KrHaaland/5-Volt-Buck-with-UVLO/case/case-closed.png

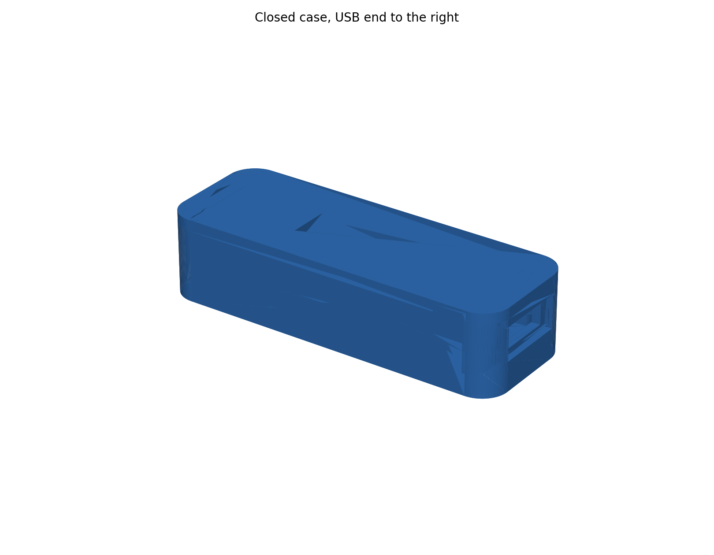
case/case-closed.png
