KrHaaland/5-Volt-Buck-with-UVLO/production/bom.csv

Designator | Footprint | Quantity | Value | LCSC Part #
_3, _2, |  | 3
C1, C10, C11, C2, C6, C7, C9 | 1206 | 7 | 10uF
C3, C5, C8 | 0805 | 3 | 100nF
C4 | 0805 | 1 | 33nF
J1 | Wago 2060-452 | 1 | Wago 2060-452 | C2765055
J2 | 292303-1 | 1 | 292303-1
L1 | 744393465068 | 1 | 7070_74439387068
R1 | 0805 | 1 | 511K
R2 | 0805 | 1 | 88.7K
R3, R4 | 0805 | 2 | 0 ohm
R6 | 0805 | 1 | 53.6k
R7 | 0805 | 1 | 10.2k
U1 | TPS62933 | 1 | TPS62933DRLR
