KrHaaland/5-Volt-Buck-with-UVLO/case/usb-adapter-case-assembled.step

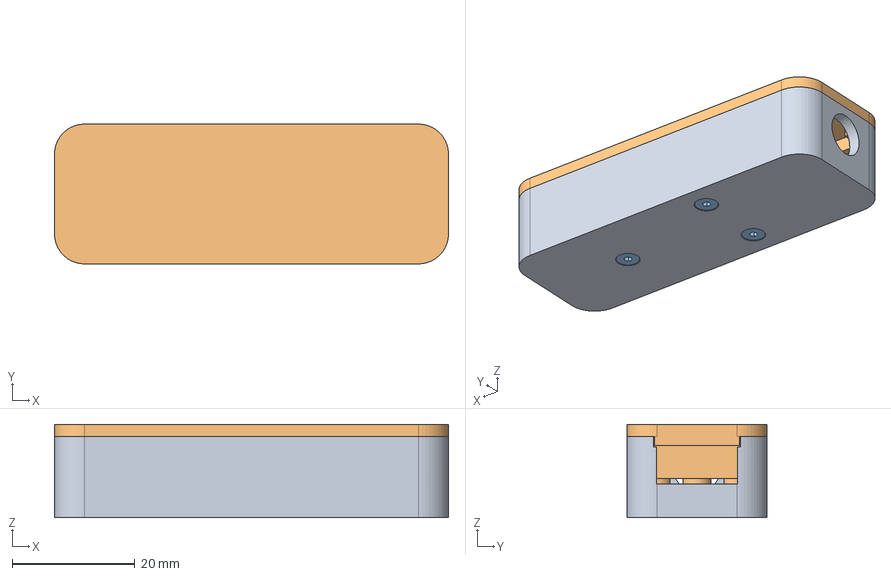
[picture p7: CAD file, 2026-11-08]
case/usb-adapter-case-assembled.step
64.2 x 22.8 x 15.2 mm
Case_Base
Case_Lid
Screw_M2x6_1
Screw_M2x6_2
Screw_M2x6_3
