KrHaaland/5-Volt-Buck-with-UVLO/case/usb-adapter-assembly.step

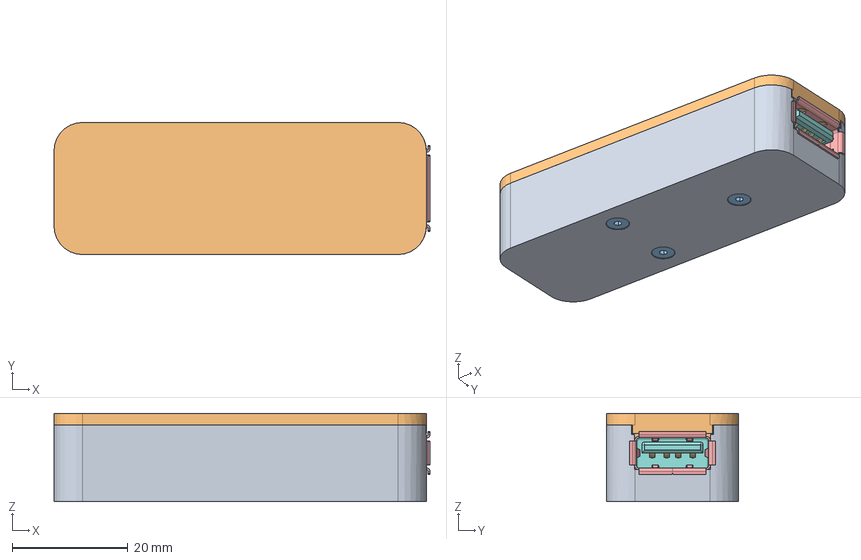
[picture p8: CAD file, 2026-11-08]
case/usb-adapter-assembly.step
64.9 x 22.8 x 15.2 mm
Base
Lid
Screw 1 M2x6 hex socket pan head
Screw 2 M2x6 hex socket pan head
Screw 3 M2x6 hex socket pan head
J1 Wago 2060-452
C6 C_1206_3216Metric
C8 C_0805_2012Metric
L1 L_Wurth_WE-XHMI-6060 (fitted part is a 7070)
C1 C_1206_3216Metric
U1 TPS62933
C9 C_1206_3216Metric
C11 C_1206_3216Metric
R4 R_0805_2012Metric
C3 C_0805_2012Metric
C7 C_1206_3216Metric
R6 R_0805_2012Metric
R1 R_0805_2012Metric
C2 C_1206_3216Metric
R7 R_0805_2012Metric
J2 292303-012
C5 C_0805_2012Metric
C4 C_0805_2012Metric
R2 R_0805_2012Metric
C10 C_1206_3216Metric
Board 40x18x1.6
