KrHaaland/5-Volt-Buck-with-UVLO/USB-Adapter.step

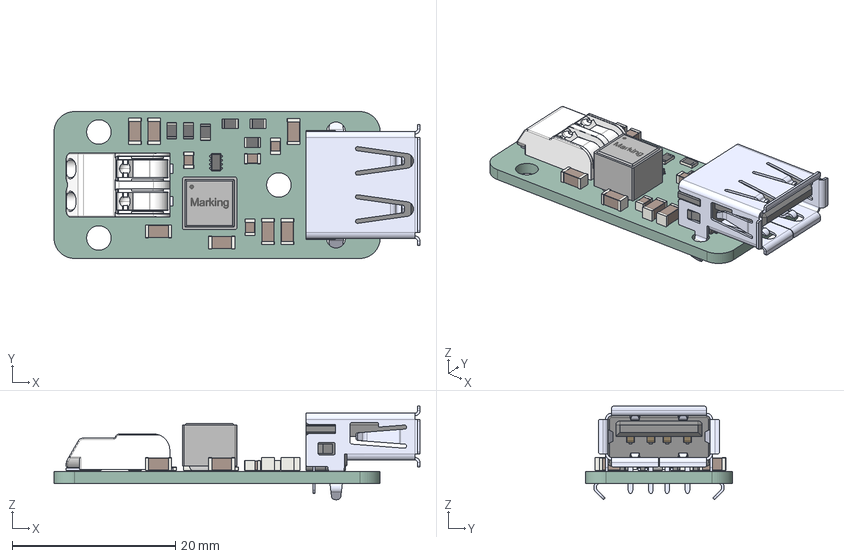
[picture p9: CAD file, 2026-11-01]
USB-Adapter.step
44.9 x 18.0 x 11.5 mm
C_1206_3216Metric x 7
C_0805_2012Metric x 4
L_Wurth_WE-XHMI_6060
BODY-SOT
R_0805_2012Metric x 6
USB-Adapter-unsaved-export-dCwAko_PCB
