KrHaaland/5-Volt-Buck-with-UVLO/case/usb-adapter-case-lid.step

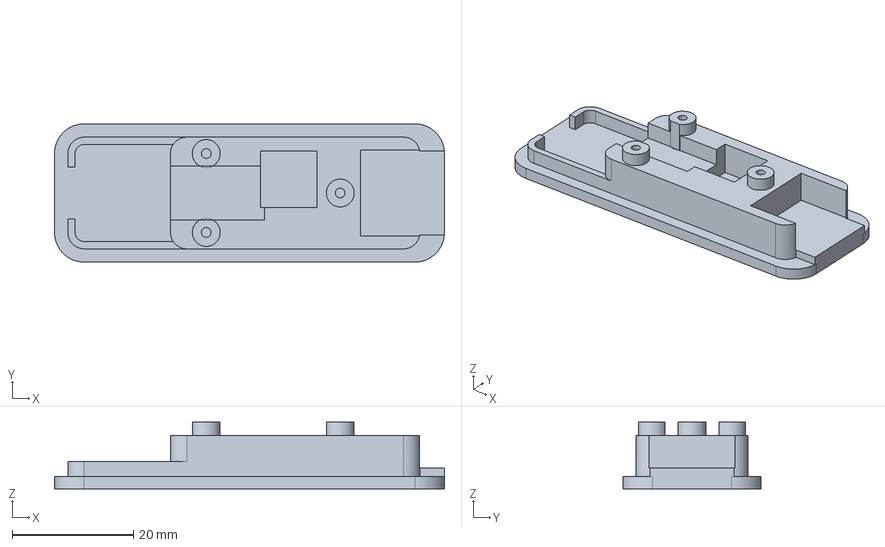
[picture p10: CAD file, 2026-11-08]
case/usb-adapter-case-lid.step
64.2 x 22.8 x 11.0 mm
