KrHaaland/5-Volt-Buck-with-UVLO/case/usb-adapter-case-base.step

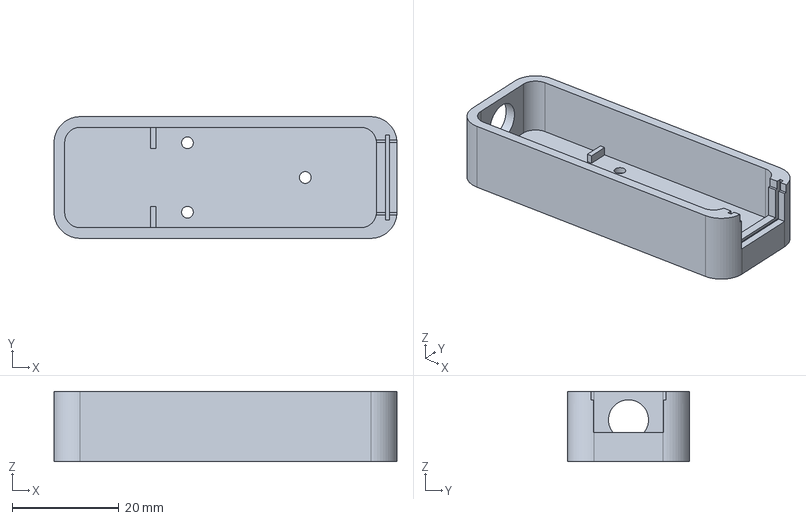
[picture p11: CAD file, 2026-11-08]
case/usb-adapter-case-base.step
64.2 x 22.8 x 13.2 mm
