KrHaaland/5-Volt-Buck-with-UVLO/case/usb-adapter-case.step

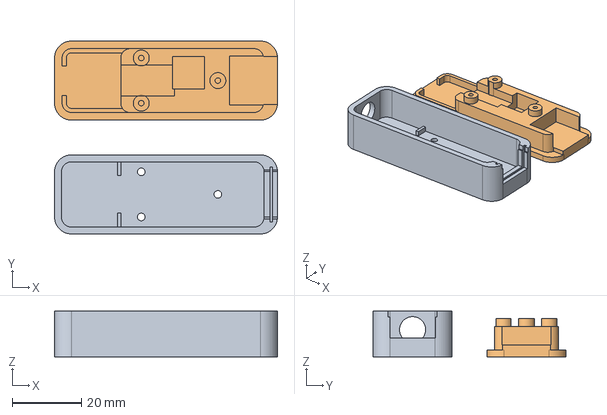
[picture p12: CAD file, 2026-11-08]
case/usb-adapter-case.step
64.2 x 55.6 x 13.2 mm
Base_print
Lid_print
