KrHaaland/5-Volt-Buck-with-UVLO/(list of files, cad)

Other CAD files:
case/usb-adapter-case-base.stl
case/usb-adapter-case-lid.stl
