KrHaaland/5-Volt-Buck-with-UVLO/schematic.pdf

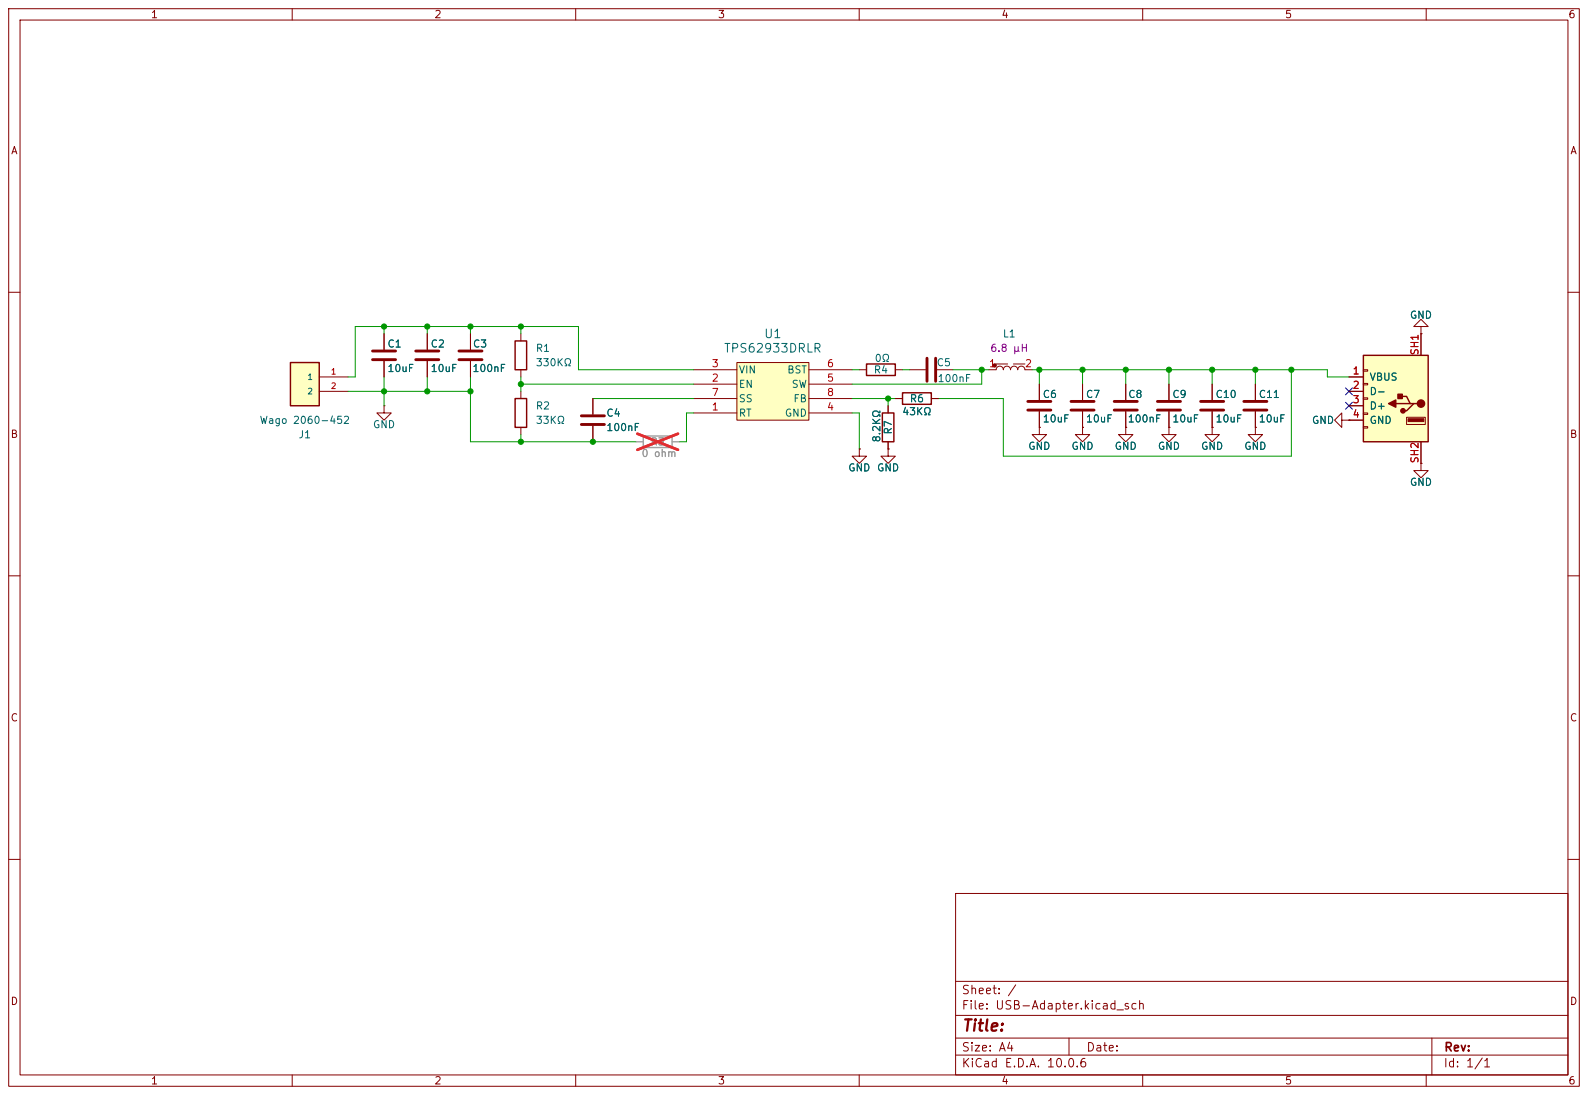
[picture p13: page 1]

Size: A4 | Rev:
KiCad E.D.A. 10.0.6 | Id: 1/1
