KrHaaland/5-Volt-Buck-with-UVLO/USB-Adapter.kicad_pcb

## KiCad design USB-Adapter.kicad_pcb (2026-10-31)

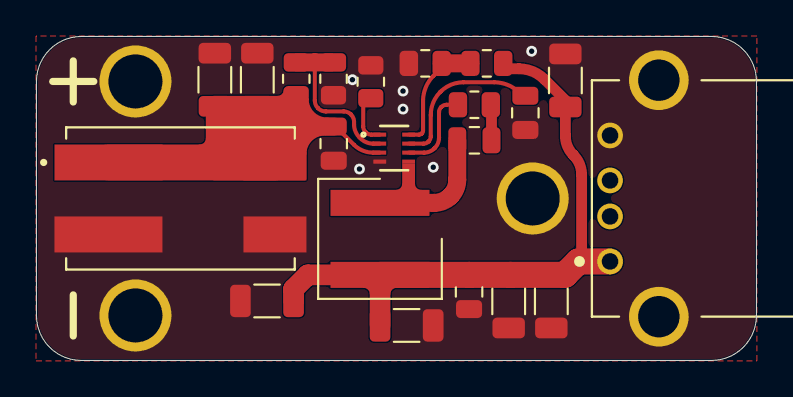
[picture p14: board USB-Adapter.kicad_pcb from above]

Board: 2 copper layers, 40.0 x 18.0 mm, 21 parts (0 on the bottom side), 10 nets.

Parts:
C1, C2, C6, C7, C9, C10, C11: 10uF; C_1206_3216Metric
C3, C5, C8: 100nF; C_0805_2012Metric
C4: 33nF; C_0805_2012Metric
J1: Wago 2060-452
J2: 292303-1
L1: 7070_74439387068; 744393465068
R1: 511K; R_0805_2012Metric
R2: 88.7K; R_0805_2012Metric
R3, R4: 0 ohm; R_0805_2012Metric
R6: 53.6k; R_0805_2012Metric
R7: 10.2k; R_0805_2012Metric
U1: TPS62933DRLR; TPS62933

Connections:
GND: C1.2, C2.2, C3.1, C4.2, C6.2, C7.2, C8.1, C9.2, C10.2, C11.2, J1.2, J2.4 (GND), J2.SH1, J2.SH2, R2.2, R3.2, R7.1, U1.4 (GND)
unnamed: C5.1, R4.2
unnamed: C6.1, C7.1, C8.2, C9.1, C10.1, C11.1, J2.1 (VBUS), L1.2, R6.2
unnamed: R4.1, U1.6 (BST)
unnamed: R1.2, R2.1, U1.2 (EN)
unnamed: R6.1, R7.2, U1.8 (FB)
unnamed: R3.1, U1.1 (RT)
unnamed: C4.1, U1.7 (SS)
unnamed: C5.2, L1.1, U1.5 (SW)
unnamed: C1.1, C2.1, C3.2, J1.1, R1.1, U1.3 (VIN)
