KrHaaland/5-Volt-Buck-with-UVLO/(commit log)

2026-10-31 Initial commit: 5 Volt Buck with UVLO KiCad project
    USB-Adapter schematic, PCB and production outputs (BOM, positions, netlist).
    [USB-Adapter.kicad_pcb, USB-Adapter.kicad_sch, bom.csv, designators.csv, positions.csv]
2026-10-31 Add README with as-built resistor values and tuning log
2026-10-31 Add schematic PDF and note on disabling UVLO
2026-10-31 Add 3D render of the board to README
2026-10-31 Add photo of the assembled board
2026-11-01 Add 3D-printable case (STEP/STL) generated from the PCB geometry
    Claude-Session: https://claude.ai/code/session_01GDeBLW4npXiq4WbrnEu7Dp
    [usb-adapter-case-assembled.step, usb-adapter-case-base.stl, usb-adapter-case-lid.stl, usb-adapter-case.step]
2026-11-01 Case: 1 mm standoff (pins trimmed flush), 10 mm wire-end extension with zip-tie anchor
    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
    [usb-adapter-case-assembled.step, usb-adapter-case-base.stl, usb-adapter-case-lid.stl, usb-adapter-case.step]
2026-11-01 Case: drop zip-tie floor slots, extension is plain space for a tie as pull stop
    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
    [usb-adapter-case-assembled.step, usb-adapter-case-base.stl, usb-adapter-case.step]
2026-11-01 Case: model the three M2.5 screws in the assembled STEP, add section view
    - Screws (pan head 5.0 x 2.0 mm, shank 2.5 x 10 mm) as separate solids in
    usb-adapter-case-assembled.step; check confirms they clear base and board
    and engage 6.9 mm in the lid bosses
    - Floor counterbore 1.8 -> 2.1 mm so a pan head sits below the bottom face;
    lid pilot hole 7.0 -> 7.5 mm deep for tip clearance
    - case-section.png half section through the screw stack; README fastening
    text expanded
    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
    [usb-adapter-case-assembled.step, usb-adapter-case-base.stl, usb-adapter-case-lid.stl, usb-adapter-case.step]
2026-11-01 Case: build the check and assembled model from the KiCad STEP export of the board
    - Add USB-Adapter.step (populated board exported from KiCad) and the project
    setting that records the export path
    - make_case.py reads that file, shifts it into the board frame and removes
    everything below the board bottom (pins are cut flush), then checks every
    component against base and lid for overlap and clearance; the old
    per-connector model loading via KICAD_3D_MODELS is gone
    - The two lid bosses beside the Wago were 0.25 mm from the connector body:
    flatten them on that side up to the connector height, now 0.45 mm
    - Assembled STEP and previews now contain the real populated board; the
    7070 ind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
    [USB-Adapter.step, usb-adapter-case-assembled.step, usb-adapter-case-lid.stl, usb-adapter-case.step]
2026-11-01 Case: add usb-adapter-assembly.step, a full STEP assembly of case and populated board
    - New two-level STEP assembly: Case (base, lid, three screws) and PCB (board
    plus every component), parts named by reference designator taken from the
    .kicad_pcb footprints; R3 is skipped because it is not populated
    - usb-adapter-case-assembled.step is now the enclosure only (base, lid, screws)
    - README file list updated
    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
    [usb-adapter-assembly.step, usb-adapter-case-assembled.step, usb-adapter-case.step]
2026-11-01 Case: add a lid-hidden view of the assembly to the README
    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
2026-11-01 Case: end wall reaches the USB flange, latch-tab groove, no vents
    - USB end wall now ends 0.3 mm short of the connector's front flange
    (measured at X 44.55 in the board frame), so only the flange shows
    outside; wall is 3.85 mm thick there, case 56.6 mm long
    - Groove inside that wall for the shell's side latch tabs
    - All vent slots removed (lid, floor, side walls): no heat to vent
    - README table and previews updated
    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
    [usb-adapter-assembly.step, usb-adapter-case-assembled.step, usb-adapter-case-base.stl, usb-adapter-case-lid.stl, usb-adapter-case.step]
2026-11-01 Case: 15 mm between board edge and wire-end wall, 7.5 mm cable hole
    - Wire-end extension measured from the board edge to the inside of the
    wall is now exactly 15 mm (was 10.4); case length 61.2 mm
    - Cable entry 7.5 mm with a 9.5 mm outside countersink
    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
    [usb-adapter-assembly.step, usb-adapter-case-assembled.step, usb-adapter-case-base.stl, usb-adapter-case-lid.stl, usb-adapter-case.step]
2026-11-01 Case: plain cable hole (no countersink) and a lid without openings
    - Cable entry is a straight 7.5 mm hole through the end wall
    - Wago push-button access slots removed from the lid
    - README and previews updated
    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
    [usb-adapter-assembly.step, usb-adapter-case-assembled.step, usb-adapter-case-base.stl, usb-adapter-case-lid.stl, usb-adapter-case.step]
2026-11-01 Case: 18 mm between board edge and wire-end wall
    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
    [usb-adapter-assembly.step, usb-adapter-case-assembled.step, usb-adapter-case-base.stl, usb-adapter-case-lid.stl, usb-adapter-case.step]
2026-11-01 Case: separate STEP files for base and lid
    - usb-adapter-case-base.step and usb-adapter-case-lid.step, each one
    solid in print orientation with the same XY footprint
    - Print-orientation moves are baked into the shapes with transformShape:
    translate() only sets a Placement, which a single-object STEP export
    drops (verified), and transformGeometry would turn the surfaces into
    B-splines
    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
    [usb-adapter-assembly.step, usb-adapter-case-assembled.step, usb-adapter-case-base.step, usb-adapter-case-base.stl, usb-adapter-case-lid.step, usb-adapter-case-lid.stl, usb-adapter-case.step]
2026-11-01 Case: lift cable hole 1.5 mm above the floor
    The hole bottom used to sit 0.35 mm above the floor. CABLE_LIFT now sets
    the gap from the floor top to the bottom of the hole; the centre height is
    derived from it (2.65 mm above the board top). All STEP/STL files and the
    previews are regenerated; clearance check unchanged (closest 0.31 mm at
    the USB flange, by design).
    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
    [usb-adapter-assembly.step, usb-adapter-case-assembled.step, usb-adapter-case-base.step, usb-adapter-case-base.stl, usb-adapter-case-lid.step, usb-adapter-case.step]
2026-11-01 Case: M2 x 6 screws, board moved 0.5 mm towards the cable end
    Screws are now M2 x 6 pan head (2.3 mm clearance holes, 1.6 mm pilots in
    the lid bosses, 4.6 x 2.1 mm counterbores); a 6 mm screw gives 2.9 mm of
    thread in the boss, a 5 mm one only 1.9 mm.
    After the first fit check the USB flange sat 0.5 mm further from the end
    wall than modelled. BOARD_DX moves the three screw positions, the board
    stops and the board model 0.5 mm towards the cable end relative to the
    box, closing that gap; USB_DX keeps the J2 model where the flange really
    is so the clearance check stays meaningful. Board edge to cable wall is
    now 17.5 mm. All STEP/STL files and previews regenerated.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
    [usb-adapter-assembly.step, usb-adapter-case-assembled.step, usb-adapter-case-base.step, usb-adapter-case-base.stl, usb-adapter-case-lid.step, usb-adapter-case-lid.stl, usb-adapter-case.step]
2026-11-01 Case: no chamfer on the bed-side faces
    Removes the 0.6 mm chamfer around the underside of the base (and the
    counterbore mouths) and around the lid top, which is the bed side when
    the lid is printed upside down. Files regenerated.
    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
    [usb-adapter-assembly.step, usb-adapter-case-assembled.step, usb-adapter-case-base.step, usb-adapter-case-base.stl, usb-adapter-case-lid.step, usb-adapter-case-lid.stl, usb-adapter-case.step]
2026-11-01 Case: no standoff, board lies on the floor; lip notched over the cable hole
    STAND is 0: the board sits directly on the floor, the case is 0.5 mm
    lower than with the 1 mm pillars and the M2 x 6 screws get 3.9 mm of
    thread in the lid bosses. The cable hole follows the floor (bottom edge
    still 1.5 mm above it), so the lid's locating lip is notched above the
    hole to clear a full-size cable, and a cable envelope is now part of the
    clearance check. Clearances are measured on the part above the board
    top, since the flush-cut pin stubs end at the floor like the board does.
    Claude-Session: https://claude.ai/code/session_01GDeBLW4npXiq4WbrnEu7D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
    [usb-adapter-assembly.step, usb-adapter-case-assembled.step, usb-adapter-case-base.step, usb-adapter-case-base.stl, usb-adapter-case-lid.step, usb-adapter-case-lid.stl, usb-adapter-case.step]
2026-11-01 Case: model the screws as M2 x 6 cheese-head Torx (ISO 14580)
    The user's screws have 3.8 x 2.0 mm cheese heads with a Torx recess; the
    counterbore (4.6 x 2.1 mm) is unchanged and the head ends 0.1 mm inside
    the bottom face. Base and lid geometry are unchanged; only the screw
    models in the assembled STEP files and the previews differ.
    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
    [usb-adapter-assembly.step, usb-adapter-case-assembled.step, usb-adapter-case-base.step, usb-adapter-case-lid.step, usb-adapter-case.step]
2026-11-01 Revert "Case: model the screws as M2 x 6 cheese-head Torx (ISO 14580)"
    Restores the screw model and README exactly as in ae79d67; the user
    wants the model left as it is.
    This reverts commit 78a3b57.
    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
    [usb-adapter-assembly.step, usb-adapter-case-assembled.step, usb-adapter-case-base.step, usb-adapter-case-lid.step, usb-adapter-case.step]
2026-11-01 Case: tighter screw holes in the base for the measured screws
    The user's M2 screws measure 3.7 mm across the head and 1.9 mm across
    the thread: counterbore 4.6 -> 4.2 mm, clearance hole 2.3 -> 2.2 mm.
    Lid unchanged (1.6 mm pilots).
    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
    [usb-adapter-assembly.step, usb-adapter-case-assembled.step, usb-adapter-case-base.step, usb-adapter-case-base.stl, usb-adapter-case-lid.step, usb-adapter-case.step]
2026-11-01 Case: 1.4 mm counterbores so the screw heads sit flush
    The measured head height is 1.4 mm. Counterbore depth 2.1 -> 1.4 mm
    leaves 1.2 mm of floor above the head instead of 0.5; thread engagement
    in the lid bosses drops from 3.9 to 3.2 mm. Lid unchanged.
    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
    [usb-adapter-assembly.step, usb-adapter-case-assembled.step, usb-adapter-case-base.step, usb-adapter-case-base.stl, usb-adapter-case-lid.step, usb-adapter-case.step]
2026-11-01 Case: 1.5 mm counterbores so the screw heads sit flush despite the printed overhang
    Counterbore depth 1.4 -> 1.5 mm (head is 1.4 mm). 1.1 mm floor left above the
    heads, thread engagement 3.3 mm with M2 x 6. Lid unchanged.
    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
    [usb-adapter-assembly.step, usb-adapter-case-assembled.step, usb-adapter-case-base.step, usb-adapter-case-base.stl, usb-adapter-case-lid.step, usb-adapter-case.step]
2026-11-04 Case: filled lid, solid down to 3 mm above the board with pockets around the tall parts
    The lid now fills the space over the board: solid from the plate down to
    3 mm above the board top (clears the 1.6 mm 1206 capacitors), with 0.5 mm
    pockets around the Wago, the inductor (7070 envelope) and the USB shell.
    The Wago pocket is open towards the cable chamber for the wires. The pockets
    face up when the lid is printed upside down, so no supports are needed.
    The board loading in make_case.py now runs before the lid is built so the
    pockets come from the exported part geometry. Base unchanged.
    Claude-Session: https://claude.ai/code/session_01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
    [usb-adapter-assembly.step, usb-adapter-case-assembled.step, usb-adapter-case-base.step, usb-adapter-case-lid.step, usb-adapter-case-lid.stl, usb-adapter-case.step]
2026-11-08 Case: lid fill lowered to 2.2 mm above the board
    0.6 mm clearance over the 1.6 mm 1206 capacitors, the tallest small parts.
    Pockets for the Wago, inductor and USB shell unchanged. Base unchanged.
    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
    [usb-adapter-assembly.step, usb-adapter-case-assembled.step, usb-adapter-case-base.step, usb-adapter-case-lid.step, usb-adapter-case-lid.stl, usb-adapter-case.step]
2026-11-08 Case: USB slot in the base brought 0.5 mm closer to the shell on both sides and below
    The second print showed almost 1 mm of gap per side with 0.5 mm clearance,
    so the slot is now cut to the shell's nominal section (USB_SLOT_CLR = 0).
    From 0.2 mm below the lid tab's underside upwards the slot keeps its old
    width, so the current lid still fits. Lid unchanged (identical STL).
    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
    [usb-adapter-assembly.step, usb-adapter-case-assembled.step, usb-adapter-case-base.step, usb-adapter-case-base.stl, usb-adapter-case-lid.step, usb-adapter-case.step]
2026-11-08 Case: screw model gets a hex socket instead of a cross recess
    The screws used are hex socket (1.3 mm key), not Phillips. Head shape and
    all dimensions unchanged; base and lid geometry unchanged.
    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
    [usb-adapter-assembly.step, usb-adapter-case-assembled.step, usb-adapter-case-base.step, usb-adapter-case-lid.step, usb-adapter-case.step]
